eastpeak001/TinyPredict-STM32/docs/pcb_bom_v04a.md

# TinyPredict-STM32 V0.4A PCB BOM

V0.4A 是基于 Blue Pill / STM32F103C8T6 开发板的扩展底板，不直接焊接 STM32 芯片。PCB 主要用于替代面包板和杜邦线，连接 MPU6050、OLED、USB-TTL、SWD、电源、LED 和蜂鸣器接口。

## V0.4A 推荐 BOM

| 序号 | 器件 | 立创编号 | 品牌 / 厂商 | 封装 / 规格 | 用途 | 备注 |
| ---: | --- | --- | --- | --- | --- | --- |
| 1 | LCKFB-DKX-STM32F103C8T6 | C22396880 | 立创开发板 | 开发板模块 | 主控模块 | 作为 Blue Pill / STM32F103C8T6 小板插接到底板 |
| 2 | MOD-MPU6050 | C5445394 | Olimex Ltd. | 模块 | 振动传感器 | 通过 4Pin 接口连接 I2C1 |
| 3 | HS96L03W2C03 | C5248080 | HS(汉昇) | 0.96 寸 I2C OLED 模块 | 本地显示 | 与 MPU6050 共用 I2C1 |
| 4 | HX-XH2.54-4PZZ | C42391662 | hanxia(韩下) | 插件 P=2.5mm，4Pin 接口 | 外设接口 | 用于 MPU6050、OLED、USB-TTL、SWD 等 4Pin 接口 |
| 5 | AMS1117-3.3 | C22466222 | TDSEMIC(拓电半导体) | SOT223 | 3.3V 稳压 | 5V 输入转 3.3V |
| 6 | TYPE-C 6P(073) | C668623 | SHOU HAN(首韩) | SMD | 5V 电源输入 | 仅作为供电接口，不作为 USB 通信 |
| 7 | 0805F106M160NT | C90545 | FH(风华) | 0805，10uF 电容 | 电源滤波 | 稳压输入 / 输出电容 |
| 8 | 0603B104K500NT | 待确认 | FH(风华) | 0603，0.1uF 电容 | 去耦 | 放在电源和传感器接口附近 |
| 9 | 0603WAF1001T5E | C21190 | UNI-ROYAL(厚声) | 0603，1k 电阻 | LED 限流 | 电源 LED、状态 LED 限流 |
| 10 | HYT-0903 | C7544822 | HYDZ(华宇) | DIP，有源蜂鸣器 | 报警预留 | 第一版可只预留接口或焊接测试 |

## 未确定或不建议第一版使用的物料

| 器件 | 立创编号 | 说明 | V0.4A 建议 |
| --- | --- | --- | --- |
| MPU6050 芯片 | C24112 | QFN-24-EP(4x4)，直接焊接传感器芯片 | 暂不推荐，第一版优先使用已验证模块 |
| STM32F103C8T6 芯片 | 待确认 | LQFP-48，直接做完整最小系统 | 暂不推荐，V0.4A 使用开发板模块，完整最小系统放到后续版本 |
| CH343 USB-TTL 成品模块 | 不纳入 PCB BOM | 当前调试使用外部 USB 转 TTL 模块 | 不放入 PCB BOM，只保留 USB-TTL 接口 |

## BOM 使用说明

- V0.4A 的目标是降低第一版 PCB 风险，因此优先使用已经验证过的开发板和外设模块。
- MPU6050 和 OLED 均通过 4Pin 接口接入，方便更换模块和调整安装位置。
- USB-TTL 不集成到 PCB，只保留 USART1 调试接口。
- 蜂鸣器为预留功能，第一版可只验证接口，不要求固件立即支持。
- 风扇电机不要从本 PCB 取电，PCB 只负责监测、显示和通信。
