eastpeak001/TinyPredict-STM32/Core/Inc/oled_logo_pg.h

#ifndef OLED_LOGO_PG_H
#define OLED_LOGO_PG_H

#include <stdint.h>

#define OLED_LOGO_PG_WIDTH   48U
#define OLED_LOGO_PG_HEIGHT  48U

static const uint8_t OLED_LOGO_PG_BITMAP[] = {
  0x01U, 0xFFU, 0xFFU, 0xF8U, 0x00U, 0x00U, 0x01U, 0xFFU, 0xFFU, 0xFEU, 0x00U, 0x00U,
  0x01U, 0xFFU, 0xFFU, 0xFFU, 0x00U, 0x00U, 0x01U, 0xFFU, 0xFFU, 0xFFU, 0x80U, 0x00U,
  0x01U, 0xFFU, 0xFFU, 0xFFU, 0xC0U, 0x00U, 0x01U, 0xFFU, 0xFFU, 0xFFU, 0xF0U, 0x00U,
  0x01U, 0xF0U, 0x00U, 0x07U, 0xFCU, 0x00U, 0x01U, 0xF0U, 0x00U, 0x03U, 0xFCU, 0x00U,
  0x01U, 0xF0U, 0x00U, 0x03U, 0xF0U, 0x00U, 0x01U, 0xF0U, 0x00U, 0x01U, 0xF0U, 0x00U,
  0x01U, 0xF0U, 0x00U, 0x01U, 0xF0U, 0x00U, 0x01U, 0xF0U, 0x00U, 0x01U, 0xF0U, 0x00U,
  0x01U, 0xF0U, 0x00U, 0x01U, 0xF0U, 0x00U, 0x01U, 0xF0U, 0x00U, 0x03U, 0xF0U, 0x00U,
  0x01U, 0xF0U, 0x00U, 0x03U, 0xF0U, 0x00U, 0x01U, 0xF0U, 0x00U, 0x07U, 0xE0U, 0x00U,
  0x01U, 0xF0U, 0x00U, 0x1FU, 0xE0U, 0x00U, 0x01U, 0xF3U, 0xFFU, 0xFFU, 0xC0U, 0x00U,
  0x01U, 0xF3U, 0xFFU, 0xFFU, 0x80U, 0x00U, 0x01U, 0xF3U, 0xFFU, 0xFFU, 0x00U, 0x00U,
  0x01U, 0xF3U, 0xFFU, 0xFEU, 0x00U, 0x00U, 0x01U, 0xF3U, 0xFFU, 0xF8U, 0x00U, 0x00U,
  0x01U, 0xF3U, 0xE0U, 0x00U, 0x00U, 0x00U, 0x01U, 0xF3U, 0xE0U, 0x00U, 0x00U, 0x00U,
  0x01U, 0xF3U, 0xE0U, 0x00U, 0x00U, 0x00U, 0x01U, 0xF3U, 0xE0U, 0x0FU, 0xFFU, 0x80U,
  0x01U, 0xF3U, 0xE0U, 0x1FU, 0xFFU, 0x80U, 0x01U, 0xF3U, 0xE0U, 0x1FU, 0xFFU, 0x80U,
  0x01U, 0xF3U, 0xE0U, 0x3FU, 0xFFU, 0x80U, 0x01U, 0xF3U, 0xE0U, 0x3FU, 0xFFU, 0x80U,
  0x01U, 0xF3U, 0xE0U, 0x3FU, 0xFFU, 0x80U, 0x01U, 0xF3U, 0xE0U, 0x00U, 0x1FU, 0x80U,
  0x01U, 0xF3U, 0xE0U, 0x00U, 0x1FU, 0x80U, 0x01U, 0xFBU, 0xE0U, 0x00U, 0x1FU, 0x00U,
  0x01U, 0xFBU, 0xF0U, 0x00U, 0x3FU, 0x00U, 0x01U, 0xFBU, 0xF0U, 0x00U, 0x3FU, 0x00U,
  0x00U, 0xF9U, 0xF8U, 0x00U, 0x7EU, 0x00U, 0x00U, 0xFDU, 0xFCU, 0x00U, 0xFEU, 0x00U,
  0x00U, 0x7CU, 0xFFU, 0x03U, 0xFCU, 0x00U, 0x00U, 0x7EU, 0x7FU, 0xFFU, 0xF8U, 0x00U,
  0x00U, 0x3FU, 0x7FU, 0xFFU, 0xF0U, 0x00U, 0x00U, 0x3FU, 0x9FU, 0xFFU, 0xE0U, 0x00U,
  0x00U, 0x1FU, 0xCFU, 0xFFU, 0xC0U, 0x00U, 0x00U, 0x0FU, 0xE3U, 0xFFU, 0x00U, 0x00U,
  0x00U, 0x07U, 0xF8U, 0x30U, 0x00U, 0x00U, 0x00U, 0x03U, 0xFEU, 0x00U, 0x00U, 0x00U,
  0x00U, 0x00U, 0xFFU, 0xF8U, 0x00U, 0x00U, 0x00U, 0x00U, 0x1FU, 0xF0U, 0x00U, 0x00U
};

#endif /* OLED_LOGO_PG_H */
