eastpeak001/TinyPredict-STM32/(commit log)

2026-05-03 V0.4B minimal system PCB project
    [tinypredict_20260502_193501.csv, tinypredict_idle_20260502_203200.csv, tinypredict_normal_20260502_203243.csv, tinypredict_severe_unbalance_20260502_205423.csv, tinypredict_slight_unbalance_20260502_203629.csv, tinypredict_slight_unbalance_20260502_204424.csv, tinypredict_slight_unbalance_20260502_204618.csv, tinypredict_slight_unbalance_20260502_204730.csv]
2026-05-03 Update README for V0.4B minimal system PCB
